babeinlovexd/Insane-Sound-System/BOM/BOM_insane-sound-system-v5_2026-03-22.csv

ID | Name | Designator | Footprint | Quantity
1 | 1uF | C1,C2,C3,C4,C5,C6,C9,C11,C14,C15,C16,C18,C31 | C1210 | 13
2 | 100nF | C7,C17,C19,C27,C28,C29,C30,C32,C36,C37,C41,C42,C45,C49 | C1210 | 14
3 | 220nF | C8,C10,C12,C13 | C1210 | 4
4 | 330uF | C20 | CAP-TH_BD8.0-P3.50-D0.6-FD | 1
5 | 50V470uF | C22,C23,C24,C25 | CAP-TH_BD10.0-P5.00-D1.0-FD | 4
6 | 10uF | C26,C33,C34,C35,C38,C39,C40,C48,C50 | C1210 | 9
7 | 2.2uF | C43,C44 | C1210 | 2
8 | 4.7nF | C46,C47 | C1210 | 2
9 | C-FAN | CN4 | CONN-TH_XH2.54-2P | 1
10 | SS14_C509048 | D2 | DO-214AC_L5.0-W2.5-LS5.0-FD | 1
11 | 50V1000uF | D-TPA | CAP-TH_BD13.0-P5.00-D0.6-FD | 1
12 | LM75AD | ESP,MP1584,TPA3110D | SOIC-8_L5.0-W4.0-P1.27-LS6.0-BL | 3
13 | MP 500mA | F1 | F2410 | 1
14 | LED ZONE1 3A | F2 | F2410 | 1
15 | LED ZONE2 3A | F3 | F2410 | 1
16 | LED ZONE3 3A | F4 | F2410 | 1
17 | LED 8A | F6 | F2410 | 1
18 | AMP 3.15A | F7 | F2410 | 1
19 | I2C | H1 | HDR-TH_4P-P2.54-V-M | 1
20 | Ex. | H2 | HDR-TH_4P-P2.54-V-M | 1
21 | 4.7uH | L1 | IND-SMD_L7.3-W7.3_CTCDRH74 | 1
22 | 10uH | L2,L3,L4,L5 | IND-SMD_L12.0-W12.0_CDRH127NP | 4
23 | BCP56-16 | Q1 | SOT-223-3_L6.5-W3.4-P2.30-LS7.0-BR | 1
24 | 6C-BC817-40 | Q3 | SOT-23-3_L2.9-W1.6-P1.90-LS2.8-BR | 1
25 | 10Ω | R1 | R1206 | 1
26 | 10kΩ | R2,R3,R4,R6,R7,R24,R25 | R1206 | 7
27 | 100kΩ | R5,R19 | R1206 | 2
28 | 75Ω | R8,R9,R10 | R1206 | 3
29 | 1kΩ | R11,R12,R20,R21 | R1206 | 4
30 | 22Ω | R13,R14,R15,R16,R17,R18 | R1206 | 6
31 | 470Ω | R22,R23 | R1206 | 2
32 | 470Ω | R26,R27 | R1210 | 2
33 | TPA3110D2PWP | U1 | HTSSOP-28_L9.7-W4.4-P0.65-LS6.4-BL-EP-2 | 1
34 | KF126-5.0-3P | U6,U7,U8 | CONN-TH_3P-P5.00_KF126-5.0-3P | 3
35 | PCM5102APW | U9 | TSSOP-20_L6.5-W4.4-P0.65-LS6.4-BL | 1
36 | SN74AHCT125DR | U10 | SOIC-14_L8.7-W3.9-P1.27-LS6.0-BL | 1
37 | PZ2.54-2*4 | U11 | HDR-TH_8P-P2.54-V-M-R2-C4-S2.54 | 1
38 | AMS1117-3.3V | U13,U18 | SOT-223-4_L6.5-W3.5-P2.30-LS7.0-BR | 2
39 | ESP-WROOM-32D | U14 | WIFIM-SMD_ESP-WROOM-32 | 1
40 | KF126-5.0-2P | U15,U16,U17 | CONN-TH_P5.00_KF126-5.0-2P | 3
41 | 1uF | U19,U20 | CAP-TH_L7.2-W6.5-P5.00-D0.5-1 | 2
42 | SN74CB3Q3257PWR | U22 | TSSOP-16_L5.0-W4.4-P0.65-LS6.4-BL | 1
43 | ESP32-S3-DEV-KIT-N16R8 | U23 | COMM-TH_ESP32-S3-DEVKITC-N16R8 | 1
44 | MP1584 5V COPY | U26 | MP1584 5V | 1
