babeinlovexd/Insane-Sound-System/(commit log)

2026-03-08 V5 Pre-Release
    [BOM_insane-sound-system-v4_2026-03-02.csv]
2026-03-09 ISS-V5: RMT Memory Patch & UART Bridge Implementation
    RMT Resource Optimization: Den kritischen Speicherfehler no free tx channels auf dem ESP32-S3 gelöst. Durch manuelle Aufteilung der 192 RMT-Symbole in vier 48er-Blöcke laufen nun alle 3 Zonen + Onboard-LED gleichzeitig.
    Native Platform Migration: Wechsel von der externen neopixelbus-Bibliothek auf die native esp32_rmt_led_strip Plattform für maximale Stabilität unter dem Arduino-Framework.
    Framework Integrity: Beibehaltung des Arduino-Frameworks fixiert, um die volle Kompatibilität mit dem I2S media_player für das Sound-System zu garantieren.
    UART Flashing Bridge: Einbindung eines stream_server auf Port 8888. Der S3 fungiert nun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
    [insane-sound-system-v5.yaml]
2026-03-14 Update Gerber_insane-sound-system-v5_PCB_insane-sound-system-v5_2026-03-13.zip
    Hardware-Update: Gerber Release V5.1 – Fix für Standby-Wärmeentwicklung
    Dieses Gerber-Release führt den neuen Serien-Widerstand R19 (100 kΩ) in der Shutdown-Leitung des Verstärkers ein.
    Warum ist das wichtig?
    Bei Tests der V5-Platine wurde festgestellt, dass der TPA3110D2 und die Ausgangsspulen auch im ausgeschalteten Zustand warm wurden. Die Ursache liegt in der extrem hohen Schaltgeschwindigkeit (Slew Rate) des ESP32-S3.
    Das Problem: Das Datenblatt des TPA3110D2 schreibt vor, dass die Signalflanke am /SD-Pin niemals steiler als 10 V/ms ansteigen darf.
    Die Folge: Der ESP32 schaltet im Nanosekunden-Berei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
2026-03-14 Create PCB_insane sound system v5.1_rev0.html
2026-03-15 feat: add kickstart to fan logic
    Implemented a kickstart mechanism in the ESPHome fan control logic.
    When the fan first turns on, it receives 100% power for 1 second
    before dropping to the dynamically calculated target speed. This
    ensures the fan motor has enough current to start spinning.
2026-03-16 docs: Update README installation instructions and packages references
    - Changed paths pointing to `Updater/Windows/` and `InsaneFlasher.py` to `InsaneFlasher/Windows/` and `InsaneFlasher/Linux_Mac/`.
    - Included `packaging` in pip install requirements.
    - Documented how to enable specific LED packages and Front Panel via ESPHome configuration block.
2026-03-19 feat: Migrate media_player to speaker_source architecture
    Update `ESPHome/insane-sound-system-v5.yaml` to utilize the modular `speaker`
    and `speaker_source` platforms introduced in newer ESPHome versions.
    - Create a dedicated `insane_speaker` hardware component (`platform: i2s_audio`).
    - Update the `decken_audio` media player to `platform: speaker_source`.
    - Wire `insane_speaker` into both `media_pipeline` and `announcement_pipeline`.
    - Enable `volume: restore_state: true`.
    - Maintain existing Home Assistant entity IDs, names, and automation triggers.
    - Preserve all secrets, styling, comments, and the `arduino` framework selection.
2026-03-19 Revert "Migrate media_player to new speaker_source architecture"
    [insane-sound-system-v5.yaml]
2026-03-19 feat: Migrate media_player to new speaker_source platform
    Update `ESPHome/insane-sound-system-v5.yaml` to utilize the new
    `speaker` and `speaker_source` architecture.
    - Add a dedicated `speaker` hardware block (`id: insane_speaker`, `platform: i2s_audio`).
    - Convert the `media_player` to `platform: speaker_source`.
    - Link the `insane_speaker` via `media_pipeline` and `announcement_pipeline`.
    - Maintain existing entity IDs, names, and triggers (`on_play`, `on_pause`, `on_idle`).
    - Ensure no changes to framework type or secrets.
    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
2026-03-19 fix: Add missing media_source component for speaker_source
    The new `speaker_source` platform in ESPHome requires the
    `media_source` component to be loaded in the configuration.
    Added `media_source:` to the root of the configuration file.
    [insane-sound-system-v5.yaml]
2026-03-19 fix: Correct pipeline sources and volume configuration syntax
    - Replaced invalid nested `volume: restore_state` with `volume_restore_state: true`
    which matches the ESPHome C++ struct parameters.
    - Added `sources: []` to both `media_pipeline` and `announcement_pipeline` as required
    by the `speaker_source` platform parser.
    [insane-sound-system-v5.yaml]
2026-03-19 fix: Remove unsupported volume configuration from speaker_source
    The new `speaker_source` platform in ESPHome natively persists volume
    and mute state to flash and restores it upon reboot.
    The explicit `volume_restore_state` and `volume: restore_state: true`
    attributes are unsupported and cause compiler errors, so they were removed.
    [insane-sound-system-v5.yaml]
2026-03-19 fix: Revert to stable platform: speaker architecture to retain HA proxy streaming
    - Changed `media_player` from `platform: speaker_source` to `platform: speaker`.
    The newer `speaker_source` platform does not yet officially support Home Assistant
    HTTP streaming natively without specific pluggable sources (such as `audio_file`).
    - Removed `media_pipeline` and `announcement_pipeline` nested blocks as they are
    exclusive to `speaker_source`.
    - Linked the `media_player` directly to `speaker: insane_speaker` which allows it to
    gracefully intercept and proxy both HA streams and local TTS out-of-the-box.
    - Removed invalid `volume_restore_state` and pipeline sources since they are
    not suppor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
    [insane-sound-system-v5.yaml]
2026-03-19 fix: Properly structure pipelines and mixer for platform: speaker
    - Added `platform: mixer` to correctly aggregate audio streams, as
    the `speaker` architecture strictly requires that each pipeline has
    its own unique source speaker reference rather than a direct connection
    to a shared physical speaker component.
    - Pointed the required `announcement_pipeline` and the `media_pipeline`
    to their respective virtual source speakers on the mixer.
    - Removed the explicit `volume: restore_state` block, as `platform: speaker`
    no longer supports configurable volume properties natively (state is
    persisted to flash automatically in the newer ESPHome framework).
    [insane-sound-system-v5.yaml]
2026-03-22 fix: Logikfehler in ESPHome-Konfiguration und Python-Flasher behoben
    [InsaneFlasher.py, insane-sound-system-v5.yaml]
2026-03-25 Change button pin mode from INPUT_PULLUP to INPUT
2026-03-27 Change fan PWM frequency and add parameters
2026-04-01 🧪 [testing improvement] Add unit tests for get_app_dir in InsaneFlasher.py
    This commit introduces a new test file `InsaneFlasher/Linux_Mac/test_insaneflasher.py` to provide unit tests for the `get_app_dir` function. The tests cover different operating systems (Windows and POSIX) and ensure correct directory creation logic by mocking `os` and `sys.modules` to handle external dependencies.
    🎯 What: Missing tests for get_app_dir addressed.
    📊 Coverage: Windows environment, POSIX environment, and directory creation/existence logic are now tested.
    ✨ Result: Improved test coverage and reliability for InsaneFlasher's path management.
    [test_insaneflasher.py]
2026-04-01 🔒 Security: Add authentication to ESPHome web server
    This commit addresses a security vulnerability where the ESPHome web server was unauthenticated.
    - Added `auth:` block to the `web_server:` component in `ESPHome/insane-sound-system-v5.yaml`.
    - Updated `README.md` and `README_en.md` with the new required `web_server_username` and `web_server_password` keys in the example `secrets.yaml`.
    This change ensures that users must provide credentials to access the web interface, protecting the device from unauthorized access.
2026-04-01 Refactor Arduino main loop for non-blocking serial communication
    - Replaced blocking 'delay(10)' with a non-blocking loop structure.
    - Replaced blocking 'Serial.readStringUntil("\n")' with a byte-by-byte serial reading mechanism using a 'static String' buffer.
    - Improved overall UART responsiveness for processing commands (PLAY, PAUSE, NEXT, PREV, SET_VOL:).
    - Maintained compatibility with both LF and CRLF line endings.
    [insane_bl_v5.ino]
2026-04-01 fix: Update ESPHome web server API calls to use object_id slugs
    - Fixed bug where reading sensors like "BL Firmware Version" or "Aktueller Titel" returned "Unbekannt" or "-" by using proper slugified ESPHome object IDs (e.g., `aktueller_titel`) instead of URL-encoded human-readable names (`Aktueller%20Titel`).
    - Fixed bug where pressing the "WROOM in Flash-Modus setzen" and "WROOM Normal starten" buttons via the InsaneFlasher UI failed. Updated POST endpoints to use their respective slugified names (`wroom_in_flash_modus_setzen` and `wroom_normal_starten`) rather than their YAML internal IDs.
    [InsaneFlasher.py]
2026-04-01 fix: resolve offline flasher issue and HA metadata attributes
    - Removed `auth:` from `web_server` in ESPHome config to allow unauthenticated API access for the InsaneFlasher desktop tool.
    - Fixed the Home Assistant bridge to use `media_album_name` instead of `media_album` to successfully pull the album name.
    - Added a 2-second delay and a WROOM normal restart trigger to the ESP32-S3 `on_boot` sequence. This ensures the ESP32-S3 is ready to read the Bluetooth firmware version over UART that is broadcasted upon WROOM boot.
    [insane-sound-system-v5.yaml]
2026-04-01 Fix InsaneFlasher offline status and Arduino Bluetooth firmware
    - Replaced object IDs with exact entity names in `InsaneFlasher.py` to fix offline status bugs and resolve ESPHome log deprecation warnings.
    - Simplified `insane_bl_v5.ino` to use built-in I2S handling from `ESP32-A2DP` instead of manual configuration, fixing the Bluetooth connection and data transmission issues.
    [InsaneFlasher.py, insane_bl_v5.ino]
2026-04-01 Fix Arduino compilation error and InsaneFlasher URLs
    - Updated `insane_bl_v5.ino` to use the new `I2SClass` from `ESP_I2S.h` for compatibility with ESP32 Core 3.x and `ESP32-A2DP`, replacing the legacy ESP-IDF I2S setup. This fixes the compilation error and Bluetooth pairing issues.
    - Updated `InsaneFlasher.py` to use entity names instead of object IDs in API requests, fixing offline status and resolving ESPHome deprecation warnings.
    [insane_bl_v5.ino]
2026-04-01 Fix Bluetooth Play/Pause and missing metadata
    - Forked `esphome-stream-server` into a local `custom_components` directory and patched `stream_server.cpp` so it only reads from UART when a client is actively connected (during flashing). This fixes the issue where the stream server constantly stole incoming bytes, preventing ESPHome from reading the Bluetooth Play/Pause state and metadata (title, artist, album, version).
    - Updated `insane-sound-system-v5.yaml` to use the local `custom_components`.
    - Added a 200ms boot delay in `insane_bl_v5.ino` so the ESP32-S3 has enough time to catch the initial `VERSION:` broadcast.
    - Updated documentation to instruct users to copy the `custom_components` d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
    [insane-sound-system-v5.yaml, insane_bl_v5.ino]
2026-04-01 Fix Bluetooth Play/Pause and missing metadata
    - Moved patched `stream_server` to `components/stream_server` in the repo root.
    - Configured ESPHome YAML to pull `stream_server` from this repository directly via `git` instead of requiring manual folder copying.
    - Reverted documentation instructions regarding manual folder copying.
    - Patched `stream_server.cpp` so it only reads from UART when a client is actively connected (during flashing). This fixes the issue where the stream server constantly stole incoming bytes, preventing ESPHome from reading the Bluetooth Play/Pause state and metadata.
    - Added a 200ms boot delay in `insane_bl_v5.ino` so the ESP32-S3 has enough time to catch the initial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
    [insane-sound-system-v5.yaml]
2026-04-02 Behebt die Logik des BL Play-Pause Buttons
    - Die `on_press` Lambda-Funktion für den `BL Play-Pause` Button in `insane-sound-system-v5.yaml` wurde geändert. Sie wertet nun den tatsächlichen Hardware-Sensor `id(music_active_bl).state` aus, anstatt auf den Text-Status `id(media_status).state == "Wiedergabe"` zu prüfen.
    - Dies behebt das Problem, dass der Button die Musik nicht pausieren konnte. Der Text-Status wurde vom Multiplexer-Trigger sofort wieder mit `"Bluetooth aktiv"` überschrieben, wodurch der `"PAUSE\n"` UART-Befehl nie gesendet wurde.
    [insane-sound-system-v5.yaml]
2026-04-02 Behebt das Problem beim Fortsetzen der Bluetooth-Wiedergabe
    - Ein dedizierter, interner Text-Sensor (`bl_playback_state`) wurde in `insane-sound-system-v5.yaml` hinzugefügt, der ausschließlich den "PLAY" / "PAUSE" UART-Status des WROOM-Chips verfolgt.
    - Der "BL Play-Pause" Button wertet nun diesen isolierten Sensor aus und toggelt den Status optimistisch mit. Dies garantiert, dass bei jedem Knopfdruck abwechselnd `PAUSE\n` und `PLAY\n` an den Bluetooth-Chip gesendet werden, sodass die Musik nicht nur pausiert, sondern auch zuverlässig wieder fortgesetzt wird.
    [insane-sound-system-v5.yaml]
2026-04-02 Behebt einen Syntaxfehler im ESPHome YAML
    - Entfernt die ungültige Option `initial_value` aus dem versteckten `bl_playback_state` Text-Sensor, da ESPHome `text_sensor.template` diesen Parameter nicht unterstützt.
    - Der Sensor startet nun standardmäßig leer und nimmt beim ersten Knopfdruck oder der ersten UART-Meldung automatisch den richtigen Status an.
2026-04-03 fix: set i2s_comm_fmt to stand_msb for PCM5102A with esp-idf
    [insane-sound-system-v5.yaml]
2026-04-27 Update ESP32-A2DP library source URL
2026-04-27 Update ESP32-A2DP library source URL format
2026-04-27 Refactor release build workflow for Arduino
    Fix Arduino folder structure and update firmware handling.
2026-04-27 chore: Update Firmware (.bin) und version.txt auf 5.5.5 [skip ci]
2026-04-27 Add cleanup step for logs in release_build.yml
    Add cleanup step for Arduino logs in release build workflow
2026-04-27 chore: Update Firmware (.bin) und version.txt auf V5.5.6 [skip ci]
2026-04-27 chore: Update Firmware (.bin) und version.txt auf V5.5.7 [skip ci]
2026-04-27 chore: Update Firmware (.bin) und version.txt auf V5.5.8 [skip ci]
2026-05-02 Fix version string mismatch bug in InsaneFlasher
    - Added string sanitization to strip null bytes (\x00) and case-insensitive 'v'/'V' from local and online version strings before comparison.
    - Added a unit test in test_insaneflasher.py to verify correct behavior with invisible characters.
    - Fixed the mock setup in test_insaneflasher.py so it can be safely imported without customtkinter crashing due to issubclass() checking against MagicMock instances.
    [InsaneFlasher.py, test_insaneflasher.py]
