babeinlovexd/Insane-Sound-System/(notices)

Notices in the files:
README.md:
License: CC BY-NC-SA 4.0
